breithzell/OpenHornet/release/OHM_Modifications/OHx - Printable buttons/OH2A2A1/OH1A5-1 - ASSY, EYEBROW WARNING MODULE, RIGHT - BUTTONS.3mf

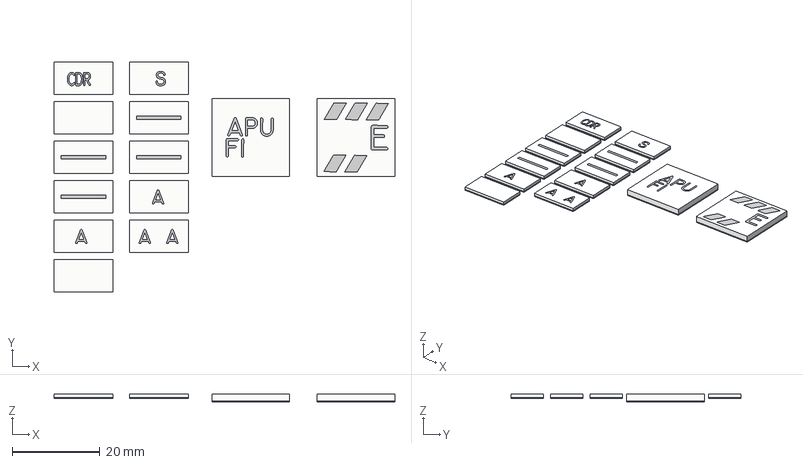
[picture p8: CAD file, 2026-04-13]
release/OHM_Modifications/OHx - Printable buttons/OH2A2A1/OH1A5-1 - ASSY, EYEBROW WARNING MODULE, RIGHT - BUTTONS.3mf
77.7 x 52.3 x 1.84 mm
