breithzell/OpenHornet/release/OHM_Modifications/OHx - Printable buttons/OH2A2A1/OH1A4-1 - ASSY, EYEBROW WARNING MODULE, TOGETHER.3mf

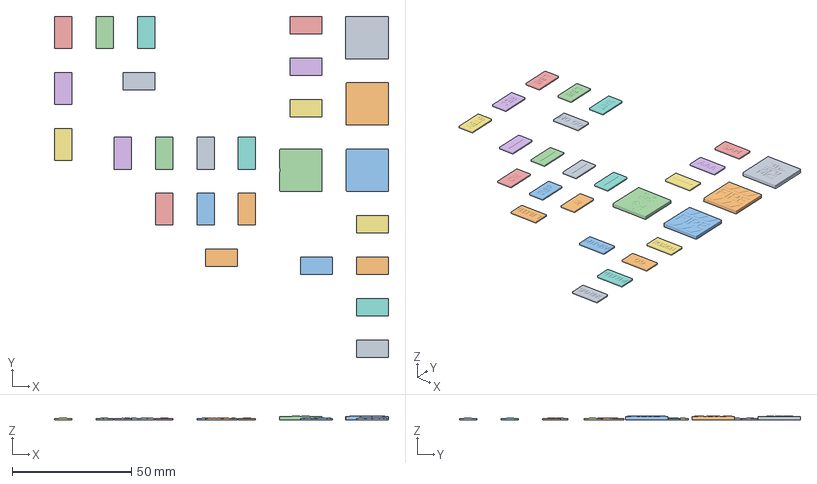
[picture p9: CAD file, 2026-04-13]
release/OHM_Modifications/OHx - Printable buttons/OH2A2A1/OH1A4-1 - ASSY, EYEBROW WARNING MODULE, TOGETHER.3mf
140.3 x 143.1 x 1.84 mm
Assembly x 26
