breithzell/OpenHornet/release/OHM_Modifications/OHx - Printable buttons/OH2A2A1 - IFEI/OH2A2A1-1 - ASSY, LEFT LIP BUTTONS.3mf

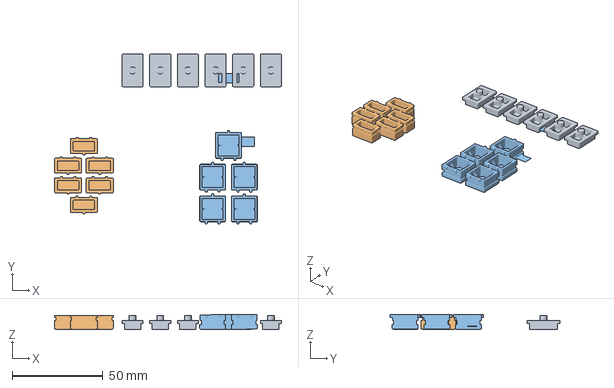
[picture p10: CAD file, 2026-04-13]
release/OHM_Modifications/OHx - Printable buttons/OH2A2A1 - IFEI/OH2A2A1-1 - ASSY, LEFT LIP BUTTONS.3mf
125.1 x 93.6 x 8.02 mm
OH2A2A1-1 - ASSY, LEFT LIP MODULE x 2
IFEI_buttons
