breithzell/OpenHornet/release/OHM_Modifications/OH1 - Winwing MIP Integration by Ulukaii/V2/ACRL_OH1A1-12_MOD_A - UPPER INSTRUMENT PANEL FACE.step

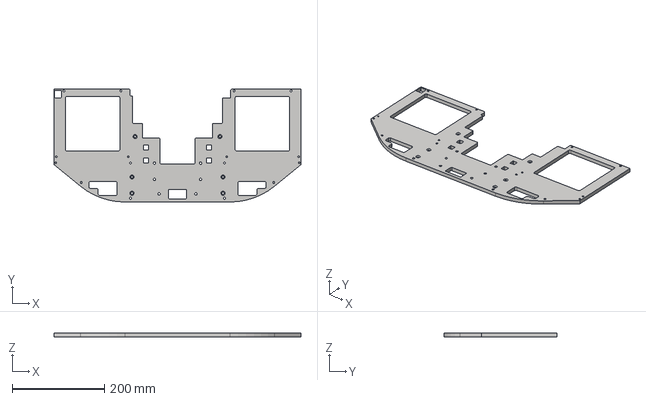
[picture p11: CAD file, 2024-11-28]
release/OHM_Modifications/OH1 - Winwing MIP Integration by Ulukaii/V2/ACRL_OH1A1-12_MOD_A - UPPER INSTRUMENT PANEL FACE.step
535.9 x 245.2 x 7.79 mm
