breithzell/OpenHornet/release/OHM_Modifications/OH2A7A1 - ESP32 STANDBY INSTRUMENT MODULE/Debug parts/OH2A7A1-301 - VERTICAL VELOCITY INDICATOR BEZEL.3mf

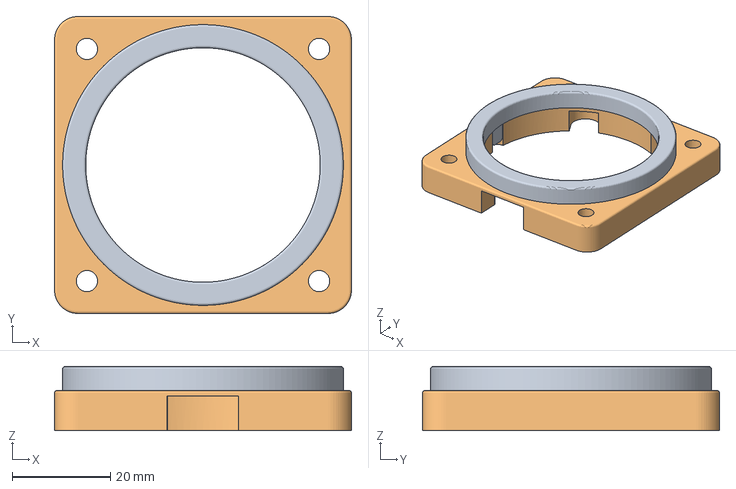
[picture p12: CAD file, 2026-05-27]
release/OHM_Modifications/OH2A7A1 - ESP32 STANDBY INSTRUMENT MODULE/Debug parts/OH2A7A1-301 - VERTICAL VELOCITY INDICATOR BEZEL.3mf
60.3 x 60.3 x 13.0 mm
