breithzell/OpenHornet/release/OHM_Modifications/OH2A7A1 - ESP32 STANDBY INSTRUMENT MODULE/OH2A7A1-MODB.3mf

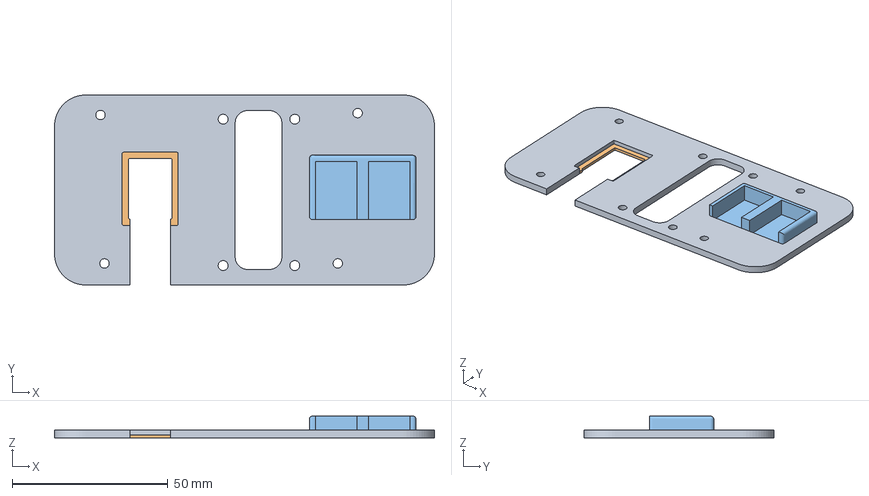
[picture p13: CAD file, 2026-09-10]
release/OHM_Modifications/OH2A7A1 - ESP32 STANDBY INSTRUMENT MODULE/OH2A7A1-MODB.3mf
122.0 x 61.0 x 7.00 mm
