breithzell/OpenHornet/release/OHM_Modifications/OHx - Printable buttons/OH2A2A1 - IFEI/RI.3mf

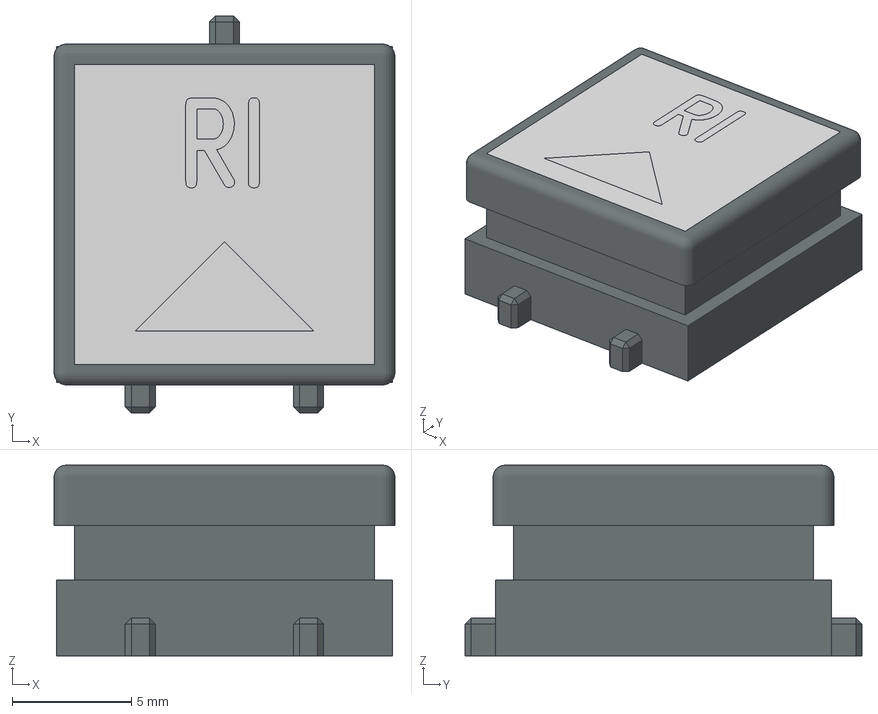
[picture p14: CAD file, 2026-04-13]
release/OHM_Modifications/OHx - Printable buttons/OH2A2A1 - IFEI/RI.3mf
14.3 x 16.6 x 8.00 mm
