breithzell/OpenHornet/release/OHM_Modifications/OH2A7A1 - ESP32 STANDBY INSTRUMENT MODULE/Debug parts/OH2A7A1-201 - ALTIMETER BEZEL.3mf

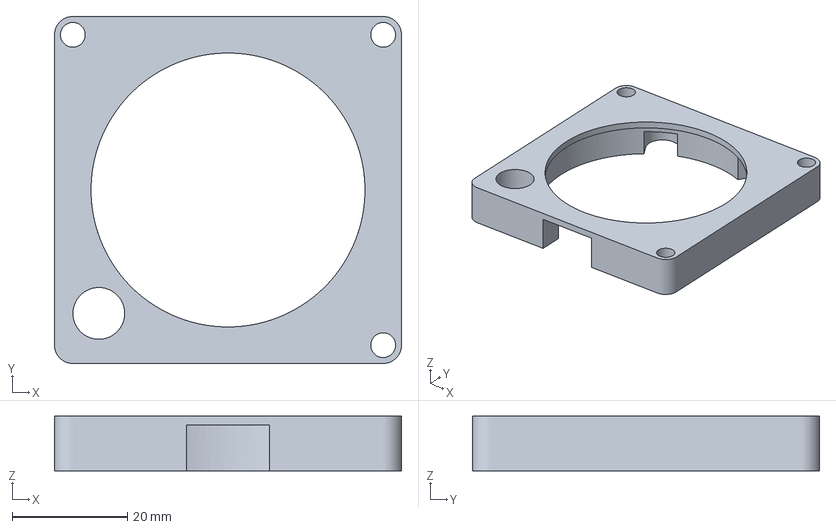
[picture p15: CAD file, 2026-05-27]
release/OHM_Modifications/OH2A7A1 - ESP32 STANDBY INSTRUMENT MODULE/Debug parts/OH2A7A1-201 - ALTIMETER BEZEL.3mf
60.3 x 60.3 x 9.53 mm
