breithzell/OpenHornet/release/OHM_Modifications/OH2A7A1 - ESP32 STANDBY INSTRUMENT MODULE/OH2A7A1-500 - SARI.3mf

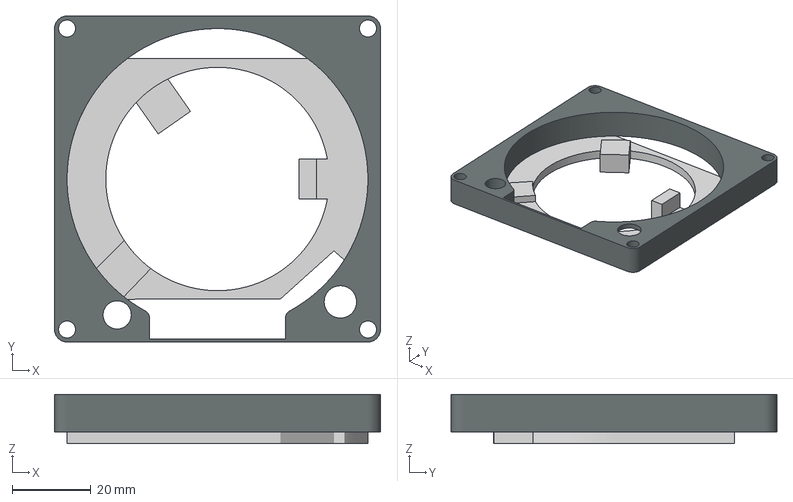
[picture p16: CAD file, 2026-08-15]
release/OHM_Modifications/OH2A7A1 - ESP32 STANDBY INSTRUMENT MODULE/OH2A7A1-500 - SARI.3mf
82.5 x 82.5 x 12.5 mm
