breithzell/OpenHornet/release/OHM_Modifications/OH2A7A1 - ESP32 STANDBY INSTRUMENT MODULE/Debug parts/OH2A7A1-101 - AIRSPEED INDICATOR BEZEL.3mf

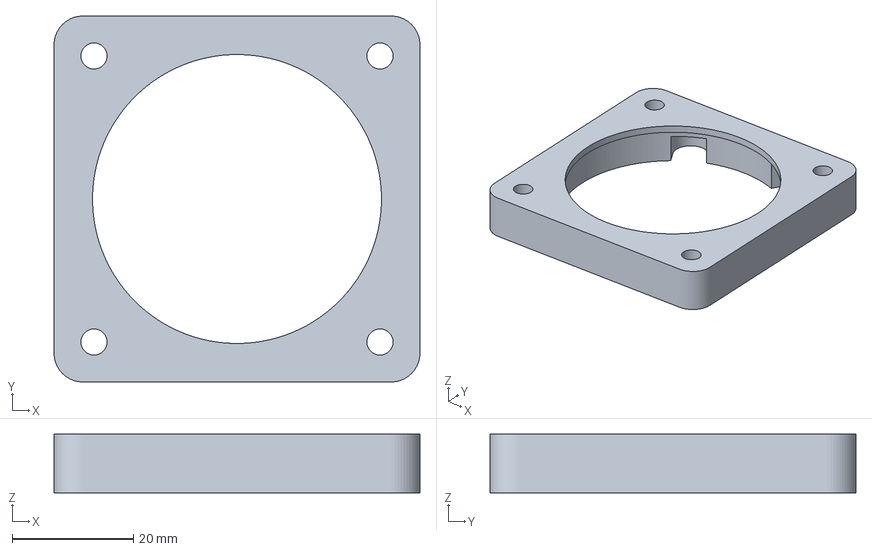
[picture p17: CAD file, 2026-05-27]
release/OHM_Modifications/OH2A7A1 - ESP32 STANDBY INSTRUMENT MODULE/Debug parts/OH2A7A1-101 - AIRSPEED INDICATOR BEZEL.3mf
60.3 x 60.3 x 9.72 mm
