breithzell/OpenHornet/release/OHM_Modifications/OH2A7A1 - ESP32 STANDBY INSTRUMENT MODULE/OH2A7A1-MODA.3mf

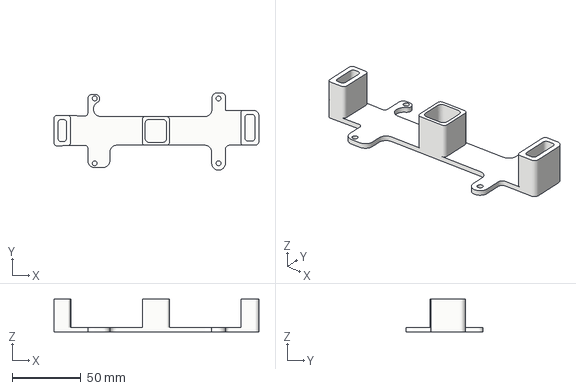
[picture p18: CAD file, 2026-05-27]
release/OHM_Modifications/OH2A7A1 - ESP32 STANDBY INSTRUMENT MODULE/OH2A7A1-MODA.3mf
149.0 x 56.2 x 23.6 mm
