breithzell/OpenHornet/release/OHM_Modifications/OHx - Printable buttons/OH2A2A1 - IFEI/RO.3mf

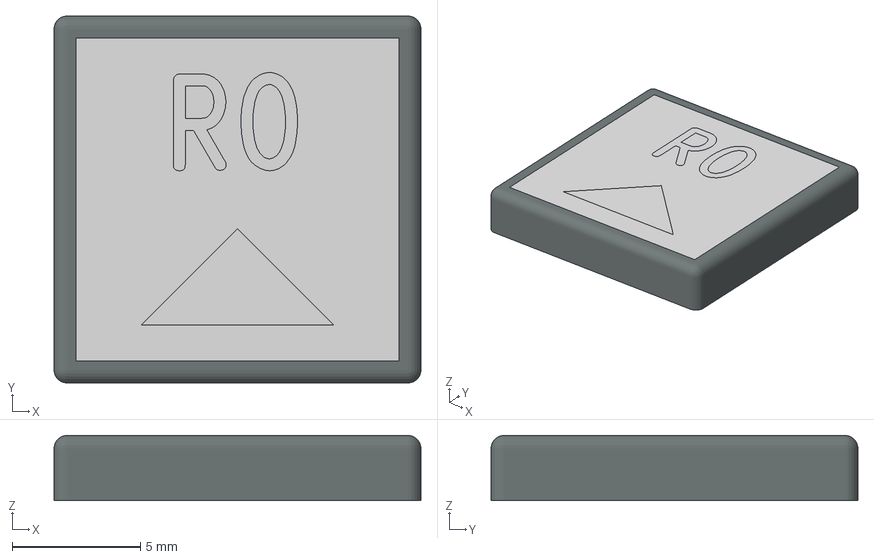
[picture p20: CAD file, 2026-04-13]
release/OHM_Modifications/OHx - Printable buttons/OH2A2A1 - IFEI/RO.3mf
14.3 x 14.3 x 2.54 mm
