breithzell/OpenHornet/release/OHM_Modifications/OHx - Printable buttons/OH2A2A1 - IFEI/IFEI_buttons.3mf

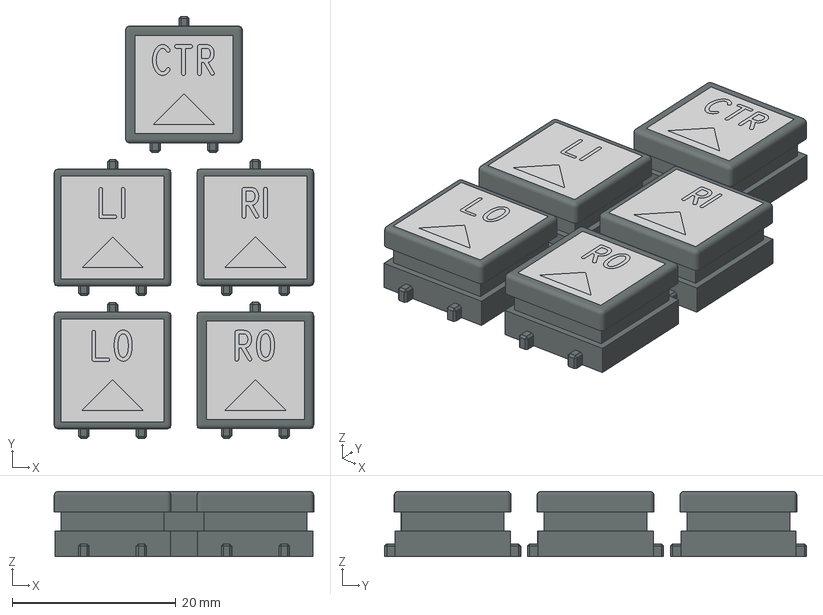
[picture p22: CAD file, 2026-04-13]
release/OHM_Modifications/OHx - Printable buttons/OH2A2A1 - IFEI/IFEI_buttons.3mf
31.7 x 51.6 x 8.00 mm
