breithzell/OpenHornet/release/OHM_Modifications/OHx - Printable buttons/OH2A2A1 - IFEI/JETT STATION SELECT BUTTON.3mf

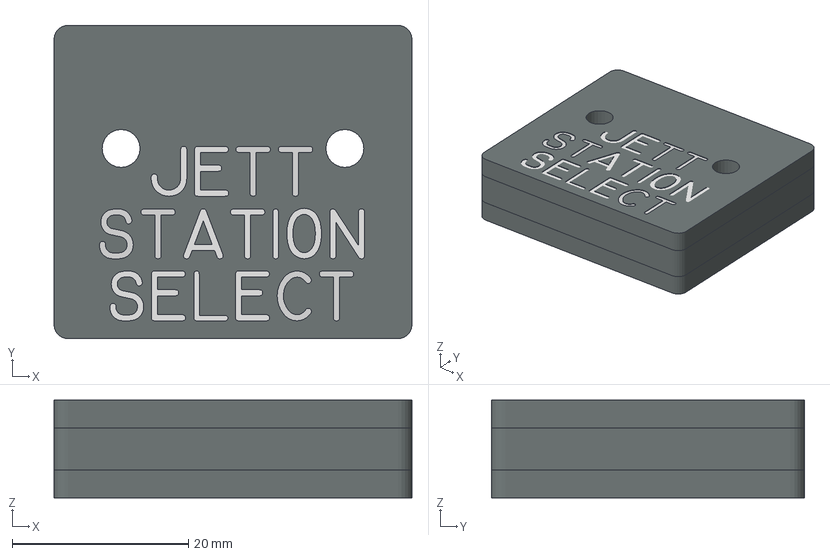
[picture p23: CAD file, 2026-04-13]
release/OHM_Modifications/OHx - Printable buttons/OH2A2A1 - IFEI/JETT STATION SELECT BUTTON.3mf
40.6 x 35.6 x 11.1 mm
