breithzell/OpenHornet/release/OHM_Modifications/OHx - Printable buttons/OH2A2A1 - IFEI/Limits box.3mf

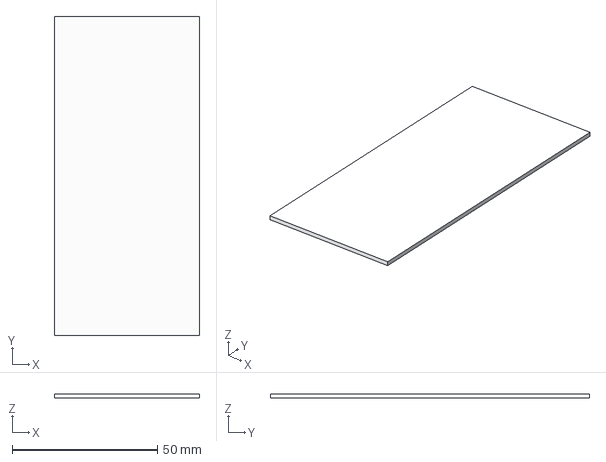
[picture p24: CAD file, 2026-04-13]
release/OHM_Modifications/OHx - Printable buttons/OH2A2A1 - IFEI/Limits box.3mf
50.0 x 110.0 x 1.50 mm
