breithzell/OpenHornet/(list of files, cad)

Other CAD files:
release/OHM_Modifications/OHx - Printable buttons/OH2A2A1/OH1A4-1 - ASSY, EYEBROW WARNING MODULE, LEFT - BUTTONS.3mf
release/OHM_Modifications/OHx - Printable buttons/OH2A2A1 - IFEI/CTR.3mf
release/OHM_Modifications/OH2A7A1 - ESP32 STANDBY INSTRUMENT MODULE/OH2A7A1-301 - VERTICAL VELOCITY INDICATOR BEZEL.3mf
release/OHM_Modifications/OH2A7A1 - ESP32 STANDBY INSTRUMENT MODULE/OH2A7A1-101 - AIRSPEED INDICATOR BEZEL.3mf
release/OHM_Modifications/OHx - Printable buttons/OH2A2A1 - IFEI/LI.3mf
release/OHM_Modifications/OHx - Printable buttons/OH2A2A1 - IFEI/LO.3mf
release/OHM_Modifications/OH2A7A1 - ESP32 STANDBY INSTRUMENT MODULE/Fusion Files/OH2A7A1-100 - AIRSPEED INDICATOR.f3z
release/OHM_Modifications/OH2A7A1 - ESP32 STANDBY INSTRUMENT MODULE/Fusion Files/OH2A7A1-200 - ALTIMETER.f3z
release/OHM_Modifications/OH2A7A1 - ESP32 STANDBY INSTRUMENT MODULE/Fusion Files/OH2A7A1-300 - VERTICAL VELOCITY INDICATOR.f3z
release/OHM_Modifications/OH2A7A1 - ESP32 STANDBY INSTRUMENT MODULE/Fusion Files/OH2A7A1-500 - SARI.f3z
