breithzell/OpenHornet/ECAD/PCBs/ABSIS/ABSIS_ALE/ABSIS_ALE.kicad_sch

## KiCad design ECAD/PCBs/ABSIS/ABSIS_ALE/ABSIS_ALE.kicad_sch (2024-10-25)

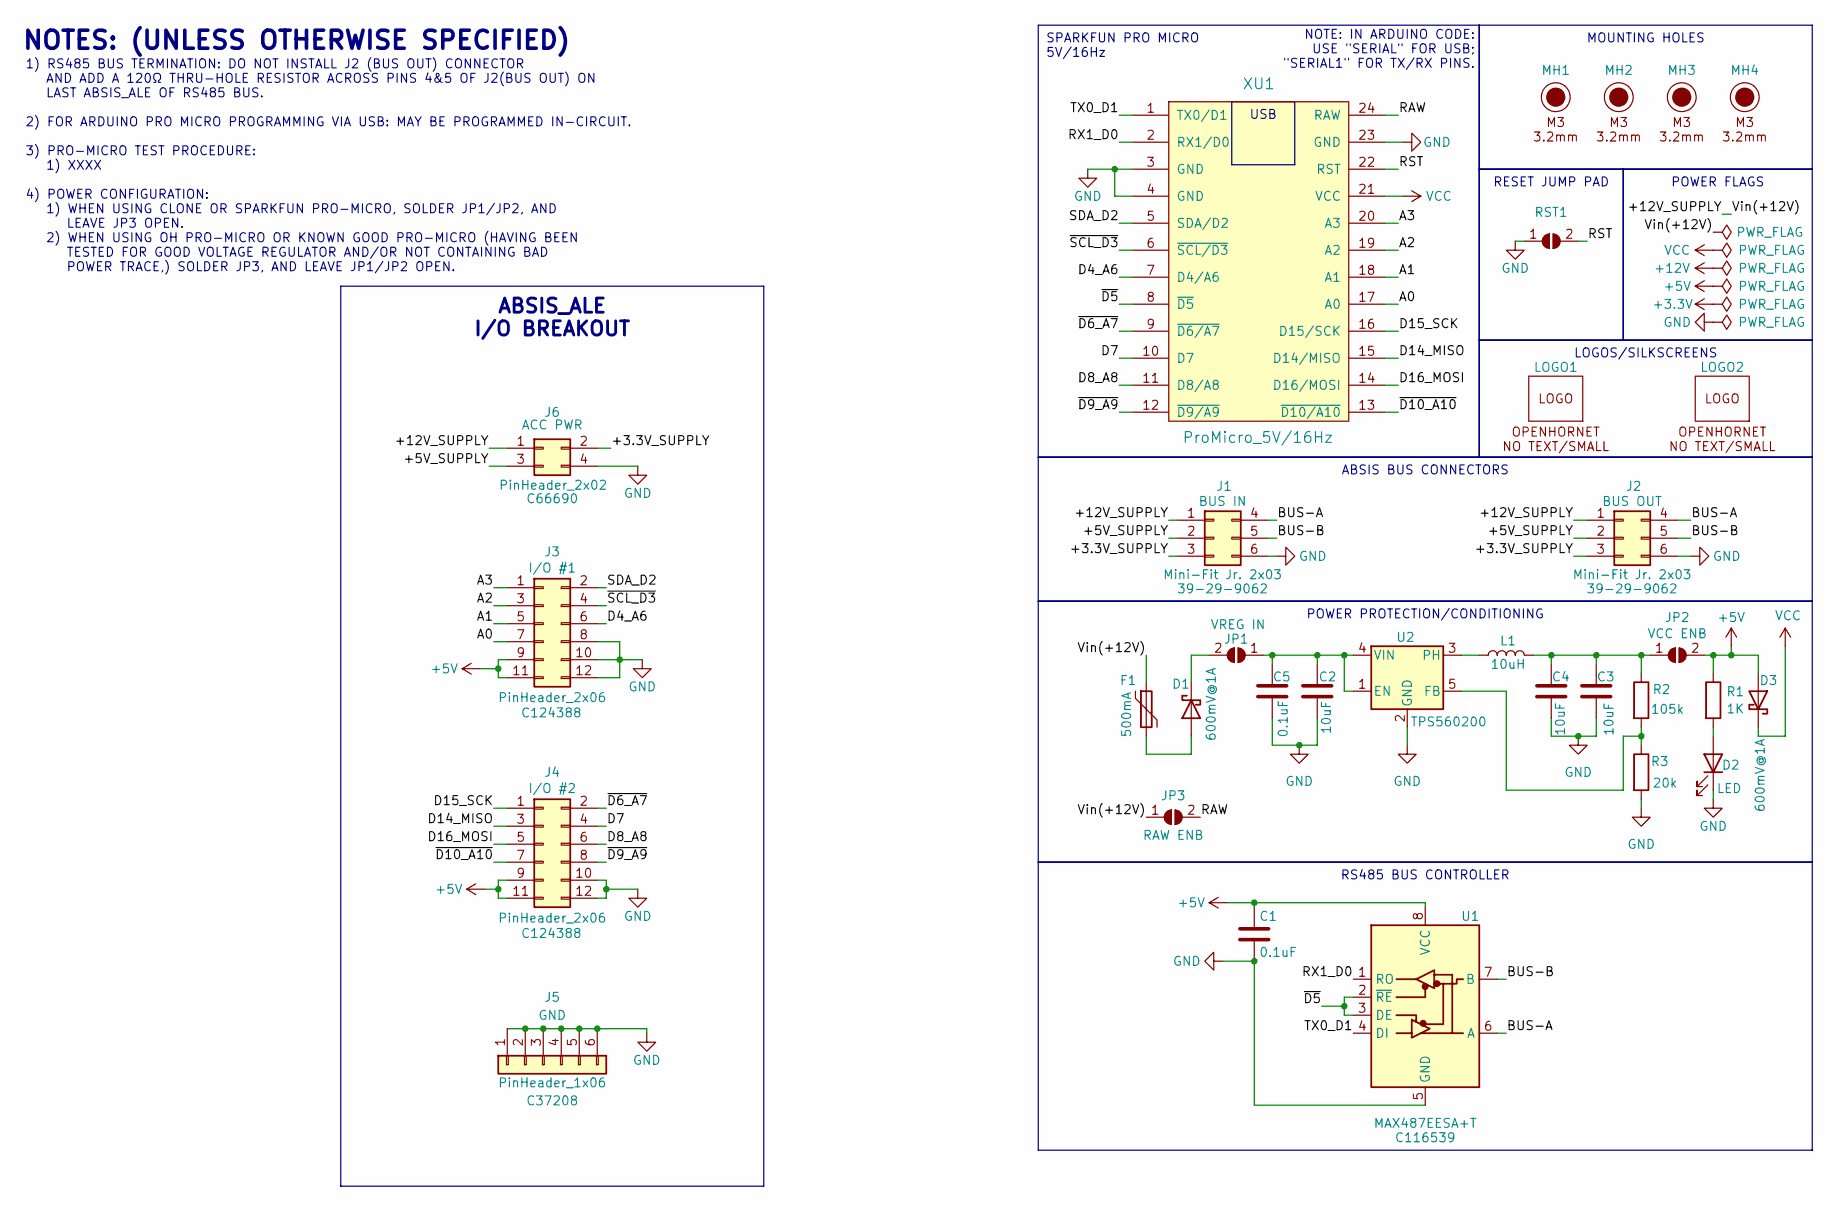
[picture p25: schematic ABSIS_ALE.kicad_sch]

Parts:
C1: 0.1uF; C_0805_2012Metric; Manufacturer PN CC0805KRX7R9BB104; LCSC C49678
C2, C3: 10uF; C_0805_2012Metric; Manufacturer PN CL21A106KAYNNNE; LCSC C15850
C4: 10uF; C_0603_1608Metric; Manufacturer PN CC0603KRX5R6BB105; LCSC C106214
C5: 0.1uF; C_0805_2012Metric; Manufacturer PN CC0603KRX7R9BB104; LCSC C14663
D1, D3: 600mV@1A; D_SOD-323_HandSoldering; Manufacturer PN 1N5819WS; LCSC C191023
D2: LED; LED_0603_1608Metric; Manufacturer PN FC-DA1608UGK-520D10; LCSC C84267
F1: 500mA; Fuse_0805_2012Metric; Manufacturer PN 0805L020/15XR; LCSC C7472558
J1, J2: Mini-Fit Jr. 2x03; Molex_Mini-Fit_Jr_5566-06A2_2x03_P4.20mm_Vertical; Manufacturer PN 39-29-9062; LCSC C505177
J3, J4: PinHeader_2x06; PinHeader_2x06_P2.54mm_Vertical; Manufacturer PN B-2100S12P-B110; LCSC C124388
J5: PinHeader_1x06; PinHeader_1x06_P2.54mm_Vertical; Manufacturer PN PH1-06-UA; LCSC C37208
J6: PinHeader_2x02; PinHeader_2x02_P2.54mm_Vertical; Manufacturer PN C66690; LCSC C66690
JP1: VREG IN; SolderJumper-2_P1.3mm_Open_RoundedPad1.0x1.5mm
JP2: VCC ENB; SolderJumper-2_P1.3mm_Open_RoundedPad1.0x1.5mm
JP3: RAW ENB; SolderJumper-2_P1.3mm_Open_RoundedPad1.0x1.5mm
L1: 10uH
LOGO1, LOGO2: LOGO; LOGO_OH_NoText_Small
MH1, MH2, MH3, MH4: M3 / 3.2mm; MountingHole_3.2mm_M3_DIN965
R1: 1K; R_0603_1608Metric; Manufacturer PN 0603WAF1001T5E; LCSC C21190
R2: 105k
R3: 20k
RST1: RST; SolderJumper-2_P1.3mm_Open_RoundedPad1.0x1.5mm
U1: MAX487EESA+T; SOIC-8_3.9x4.9mm_P1.27mm; Manufacturer PN MAX487EESA+T; LCSC C116539
U2: TPS560200; SOT-23-5; LCSC C83671
XU1: ProMicro_5V/16Hz; DIP-24_W15.24mm_Socket; Manufacturer PN Pro Micro - 5V/16MHz

Connections:
+3.3V_SUPPLY: J1.3, J2.3, J6.2
+5V: C1.1, D3.2 (A), J3.9, J3.11, J4.9, J4.11, JP2.2 (B), R1.1, U1.8 (VCC)
+5V_SUPPLY: J1.2, J2.2, J6.3
+12V_SUPPLY: F1.1, J1.1, J2.1, J6.1, JP3.1 (A)
A0: J3.7, XU1.17 (A0)
A1: J3.5, XU1.18 (A1)
A2: J3.3, XU1.19 (A2)
A3: J3.1, XU1.20 (A3)
BUS-A: J1.4, J2.4, U1.6 (A)
BUS-B: J1.5, J2.5, U1.7 (B)
D4_A6: J3.6, XU1.7 (D4/A6)
D7: J4.4, XU1.10 (D7)
D8_A8: J4.6, XU1.11 (D8/A8)
D14_MISO: J4.3, XU1.15 (D14/MISO)
D15_SCK: J4.1, XU1.16 (D15/SCK)
D16_MOSI: J4.5, XU1.14 (D16/MOSI)
GND: C1.2, C2.2, C3.2, C4.2, C5.2, D2.1 (K), J1.6, J2.6, J3.8, J3.10, J3.12, J4.10, J4.12, J5.1, J5.2, J5.3, J5.4, J5.5, J5.6, J6.4, R3.2, RST1.1 (A), U1.5 (GND), U2.2 (GND), XU1.3 (GND), XU1.4 (GND), XU1.23 (GND)
unnamed: C2.1, C5.1, JP1.1 (A), U2.1 (EN), U2.4 (VIN)
unnamed: C3.1, C4.1, JP2.1 (A), L1.2, R2.1
unnamed: D1.1 (K), JP1.2 (B)
unnamed: D1.2 (A), F1.2
unnamed: D2.2 (A), R1.2
unnamed: L1.1, U2.3 (PH)
unnamed: R2.2, R3.1, U2.5 (FB)
RAW: JP3.2 (B), XU1.24 (RAW)
RST: RST1.2 (B), XU1.22 (RST)
RX1_D0: U1.1 (RO), XU1.2 (RX1/D0)
SDA_D2: J3.2, XU1.5 (SDA/D2)
TX0_D1: U1.4 (DI), XU1.1 (TX0/D1)
VCC: D3.1 (K), XU1.21 (VCC)
~D5: U1.2 (~RE), U1.3 (DE), XU1.8 (~D5)
~D6_A7: J4.2, XU1.9 (~D6/A7)
~D9_A9: J4.8, XU1.12 (~D9/A9)
~D10_A10: J4.7, XU1.13 (~D10/A10)
~SCL_D3: J3.4, XU1.6 (~SCL/D3)

Notes on the sheet:
SPARKFUN PRO MICRO 5V/16Hz
LOGOS/SILKSCREENS
USB
RS485 BUS CONTROLLER
POWER PROTECTION/CONDITIONING
POWER FLAGS
ABSIS_ALE I/O BREAKOUT
MOUNTING HOLES
RESET JUMP PAD
ABSIS BUS CONNECTORS
NOTES: (UNLESS OTHERWISE SPECIFIED)
1) RS485 BUS TERMINATION: DO NOT INSTALL J2 (BUS OUT) CONNECTOR AND ADD A 120Ω THRU-HOLE RESISTOR ACROSS PINS 4&5 OF J2(BUS OUT) ON LAST ABSIS_ALE OF RS485 BUS. 2) FOR ARDUINO PRO MICRO PROGRAMMING VIA USB: MAY BE PROGRAMMED IN-CIRCUIT. 3) PRO-MICRO TEST PROCEDURE: 1) XXXX 4) POWER CONFIGURATION: 1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
NOTE: IN ARDUINO CODE: USE "SERIAL" FOR USB; "SERIAL1" FOR TX/RX PINS.
