breithzell/OpenHornet/release/OHM_Modifications/OH2A7A1 - ESP32 STANDBY INSTRUMENT MODULE/figs/main_assembly.png

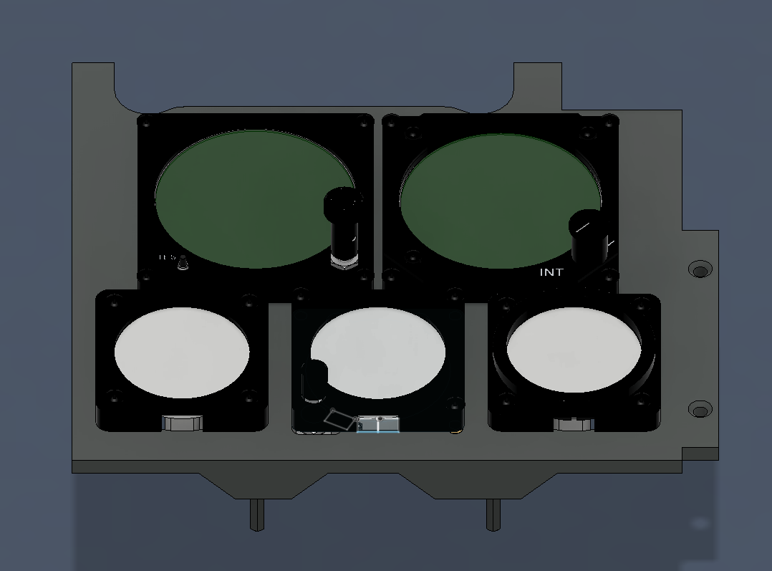
release/OHM_Modifications/OH2A7A1 - ESP32 STANDBY INSTRUMENT MODULE/figs/main_assembly.png
