breithzell/OpenHornet/(commit log)

2024-10-25 Updated ABSIS ALE power stage
    replaced LDO with a SMPS more suitable for handling the 12v to 5v drop.
    [ABSIS_ALE.kicad_sch]
2024-11-28 Added one missing hole to face plate (#1126)
    [ACRL_OH1A1-12_MOD_A - UPPER INSTRUMENT PANEL FACE.step]
2026-04-13 Printable buttons: - OH1A4-1 - ASSY, EYEBROW WARNING MODULE, LEFT - OH1A4-1 - ASSY, EYEBROW WARNING MODULE, RIGHT - OH2A2A1-1 - ASSY, LEFT LIP BUTTONS
    [CTR.3mf, IFEI_buttons.3mf, JETT STATION SELECT BUTTON.3mf, JETT_Buttons.3mf, LI.3mf, LO.3mf, Limits box.3mf, OH1A4-1 - ASSY, EYEBROW WARNING MODULE, LEFT - BUTTONS.3mf]
2026-05-27 Pre-release. Contains: - Early version of the moded parts - Early version of the models - Early version of the documentation
    [OH2A7A1-100 - AIRSPEED INDICATOR.f3z, OH2A7A1-101 - AIRSPEED INDICATOR BEZEL.3mf, OH2A7A1-200 - ALTIMETER.f3z, OH2A7A1-201 - ALTIMETER BEZEL.3mf, OH2A7A1-300 - VERTICAL VELOCITY INDICATOR.f3z, OH2A7A1-301 - VERTICAL VELOCITY INDICATOR BEZEL.3mf, OH2A7A1-MODA.3mf]
2026-08-15 Finalization: - Added holder for the SARI - Full documentation
    [OH2A7A1-500 - SARI.3mf, OH2A7A1-MODB.3mf]
2026-08-15 Added fusion files
    [OH2A7A1-500 - SARI.f3z]
2026-09-10 Modified MODB addition to account for USB-C plug
    [OH2A7A1-MODB.3mf]
