breithzell/OpenHornet/(notices)

Notices in the files:
ECAD/PCBs/ABSIS/ABSIS_ALE/ABSIS_ALE.kicad_sch:
License: CC BY-NC-SA
